InterstitialTech/quadrant-board/README.md

# Quadrant
an open-hardware interface for musical expression
