InterstitialTech/quadrant-board/(commit log)

2022-08-19 import rp2040 footprint to quadrant library
2022-08-19 import rp2040 related footprints
2022-08-19 add midi-out
    [quadrant.sch]
2022-08-19 nfet midi output
    [quadrant.sch]
2022-08-20 changed schematic general header to din-5 180 degree
    [quadrant.sch]
2022-08-20 add trs connectors
    [quadrant.sch]
2022-08-20 Create sj-352x-smt.kicad_mod
    rst jack
2022-08-20 recovering from crash
    [quadrant.sch]
2022-08-20 fixed footprint associations
    [quadrant.sch]
2022-08-20 add srt jacks
    [quadrant.kicad_pcb]
2022-08-20 add midi connector
2022-08-20 add midi footprint
    [quadrant.sch]
2022-08-22 add dac footprint + symbol
2022-08-22 dac captured
    [quadrant.sch]
2022-08-24 add VL53L0x
    [quadrant.kicad_pcb, quadrant.sch]
2022-09-07 replace midi jack with trs, add quad op-amp buffer
    [quadrant.sch]
2022-09-07 add i2c lines
    [quadrant.sch]
2022-09-07 add level shifting for dac
    [quadrant.sch]
2022-09-17 add usb-c
    [quadrant.sch]
2022-09-17 add control pull-down resistors, remove usb micro
    [quadrant.sch]
2022-10-26 add ldo regulator
2022-10-26 add ldo
    [quadrant.sch]
2022-10-26 add junctions where needed
    [quadrant.sch]
2022-10-26 add hierarchical sheets
    [DAC.sch, MIDI.sch, mcu.sch, quadrant.sch, tof-sensors.sch]
2022-10-27 move midi circuit to sheet
    [MIDI.sch]
2022-10-27 move DAC circuit to sheet
    [DAC.sch]
2022-10-27 move midi and dac to sheet, add swd header wiring
    [quadrant.sch]
2022-10-27 move tof sensors to sheet
    [tof-sensors.sch]
2022-10-27 move tof sensors to sheet, add tof enable lines
    [quadrant.sch]
2022-10-27 move mcu to sheet
    [mcu.sch, quadrant.sch]
2022-10-27 remove old mcu
    [quadrant.sch]
2022-10-27 update all passive footprints
    [DAC.sch, MIDI.sch, mcu.sch, quadrant.sch, tof-sensors.sch]
2022-10-27 start new route
    [quadrant.kicad_pcb]
2022-10-27 fixed usb5v-gnd bridge, continue placement
    [DAC.sch, MIDI.sch, mcu.sch, quadrant.kicad_pcb, tof-sensors.sch]
2022-10-28 change crystal footprint
    [mcu.sch]
2022-10-28 re-connect 2.8v to tof-2
    [tof-sensors.sch]
2022-10-28 change crystal footprint to smd
2022-10-28 place DAC components
    [quadrant.kicad_pcb]
2022-10-28 arrange TOF, vregs, bypass caps
    [quadrant.kicad_pcb]
2022-11-02 getting positions ironed out
    [quadrant.kicad_pcb]
2022-11-02 moving tof sensors
    [quadrant.kicad_pcb]
2022-11-02 tof placed
    [quadrant.kicad_pcb]
2022-11-03 change tof resistors to datasheet suggestions
    [mcu.sch, tof-sensors.sch]
2022-11-03 capacitor placement, rearranging audio jacks
    [quadrant.kicad_pcb]
2022-11-03 change mcu capacitor footprint to 0603
    [mcu.sch]
2022-11-03 starting to layout mcu caps
    [quadrant.kicad_pcb]
2022-11-03 everything is on the board!
    [mcu.sch, quadrant.kicad_pcb]
2022-11-04 just saving place
    [mcu.sch, quadrant.kicad_pcb]
2022-11-04 more routing, add 2 new layers
    [DAC.sch, mcu.sch, quadrant.kicad_pcb]
2022-11-06 finished route
    [DAC.sch, quadrant.kicad_pcb]
2022-11-10 changing footprints
    [DAC.sch, mcu.sch, quadrant.csv, quadrant.kicad_pcb, quadrant.sch, quadrant2.csv, tof-sensors.sch]
2022-11-10 add qspi flash
    [mcu.sch]
2022-11-10 fixed routing after adding flash
    [mcu.sch, quadrant.kicad_pcb, quadrant.sch]
2022-11-10 replace crystal with oscillator
    [mcu.sch, quadrant.kicad_pcb]
2022-11-10 0603 most passives
    [DAC.sch, MIDI.sch, mcu.sch, quadrant.kicad_pcb, quadrant.sch, tof-sensors.sch]
2022-11-10 using new audio jack footprint
    [MIDI.sch, quadrant.kicad_pcb, tof-sensors.sch]
2022-11-10 new audio jack
    [quadrant.csv, quadrant.kicad_pcb]
2022-11-11 update 3v3 2v8 vreg
    [quadrant.kicad_pcb, quadrant.sch]
2022-11-11 adding jlc fields
    [DAC.sch, MIDI.sch, mcu.sch, quadrant.sch, tof-sensors.sch]
2022-11-11 more jlc fields
    [DAC.sch, MIDI.sch, mcu.sch, quadrant.sch, tof-sensors.sch]
2022-11-11 replaced 4v8 reg
    [DAC.sch, quadrant.kicad_pcb]
2022-11-11 update jlc fields
    [DAC.sch]
2022-11-11 add new transistor
    [MIDI.sch]
2022-11-11 moving labels
    [MIDI.sch, quadrant.kicad_pcb]
2022-11-11 replace dual mosfet
    [DAC.sch, MIDI.sch]
2022-11-11 usb-c connector update
    [DAC.sch, quadrant.kicad_pcb, quadrant.sch]
2023-04-13 bringing things up to date (not sure what changed, maybe just generated gerbers)
    [quadrant.kicad_pcb]
2023-04-13 connect opamp supply to 4v8 and gnd
    [DAC.sch]
2023-04-13 added power to buffer amp
    [quadrant.kicad_pcb]
2023-04-13 modified trs connectors to reflect actual pinouts, added some art on the back of the pcb
    [DAC.sch, quadrant.kicad_pcb, tof-sensors.sch]
2023-04-13 update bom
    [MIDI.sch, quadrant.sch]
2023-04-15 migrate to kicad 7, add separate 3v3 and 2v8 ldo regulators, remove dual 3v3,2v8 regulator
    [DAC.kicad_sch, DAC.sch, MIDI.kicad_sch, MIDI.sch, mcu.kicad_sch, mcu.sch, quadrant.kicad_pcb, quadrant.kicad_sch]
2023-04-24 not sure why these lib files were modified
    [quadrant.csv, quadrant.kicad_pcb]
2023-04-24 moved component labels
    [DAC.kicad_sch, MIDI.kicad_sch, mcu.kicad_sch, quadrant.kicad_pcb, quadrant.kicad_sch, tof-sensors.kicad_sch]
2023-07-27 removed lcsc properties from passives
    [DAC.kicad_sch, mcu.kicad_sch, tof-sensors.kicad_sch]
2023-07-27 added diodes to xshut line on lidars
    [tof-sensors.kicad_sch]
2023-07-27 change schottky diode, update pcb
    [quadrant.kicad_pcb, tof-sensors.kicad_sch]
2023-07-27 replace reset jumper with switch
    [mcu.kicad_sch]
2023-10-17 remove kicad/ directory
    [DAC.sch, MIDI.sch, mcu.sch, quadrant.csv, quadrant.kicad_pcb, quadrant.sch, quadrant2.csv, tof-sensors.sch]
2023-10-17 rename kicad-7 -> kicad
    [DAC.kicad_sch, DAC.sch, MIDI.kicad_sch, MIDI.sch, mcu.kicad_sch, mcu.sch, quadrant.kicad_pcb, quadrant.kicad_sch]
2023-10-17 remove gerbers/, schematic.pdf, bom.csv
    [bom.csv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]
2023-10-17 remove all legacy and backup files
    [DAC.sch, MIDI.sch, mcu.sch, quadrant.sch, tof-sensors.sch]
2023-10-17 remove *.kicad_sym
2023-10-17 .gitignore: remove kicad/quadrant.xml
2023-12-12 connected MIDIO to GPIO12 and UART0 TX
    [quadrant.kicad_pcb]
2023-12-17 swap buffer to JLCpcb in-stock buffer
    [DAC.kicad_sch]
2023-12-17 shift inputs to connect UART to midi-out
    [mcu.kicad_sch]
2023-12-17 last commit before new placement and re-route
    [quadrant.kicad_pcb]
2023-12-17 add kicad symbol library with AD5317R
2023-12-17 Add AD5317R footprints
2023-12-17 Remove old DAC, remove I2c level shifting, add AD5317R
    [DAC.kicad_sch]
2023-12-17 connect DAC
    [DAC.kicad_sch, mcu.kicad_sch, quadrant.kicad_sch]
2023-12-18 begin reroute! Placed CV-outs
    [quadrant.kicad_pcb]
2023-12-18 top edge placed
    [DAC.kicad_sch, quadrant.kicad_pcb]
2023-12-18 placed TOF2
    [quadrant.kicad_pcb]
2023-12-18 placed TOF3
    [quadrant.kicad_pcb]
2023-12-18 placed TOF0
    [quadrant.kicad_pcb]
2023-12-18 add midi-in
    [MIDI.kicad_sch, mcu.kicad_sch, quadrant.kicad_pcb]
2023-12-19 connect midii and TOF gpio
    [mcu.kicad_sch, quadrant.kicad_sch, tof-sensors.kicad_sch]
2023-12-19 moved midii and midio
    [bom.csv, designators.csv, positions.csv, quadrant.kicad_pcb]
2023-12-19 route dac spi
    [quadrant.kicad_pcb]
2023-12-19 moved a cap
    [quadrant.kicad_pcb]
2023-12-19 breakout extra gpio
    [mcu.kicad_sch]
2023-12-19 wire dip switch
    [mcu.kicad_sch]
2023-12-19 add dip switch, add 4.8/5v dac output voltage, route more gpio
    [DAC.kicad_sch, mcu.kicad_sch, quadrant.kicad_pcb]
2023-12-19 mounting holes?
    [quadrant.kicad_pcb, quadrant.kicad_sch]
2023-12-19 route done?!
    [mcu.kicad_sch, quadrant.kicad_pcb, quadrant.kicad_sch]
2023-12-19 clean up silkscreen
    [quadrant.kicad_pcb]
2023-12-20 new optoisolator
    [DAC.kicad_sch, MIDI.kicad_sch, mcu.kicad_sch, quadrant.kicad_pcb, quadrant.kicad_sch]
2023-12-20 new bootsel pushbutton
    [DAC.kicad_sch, MIDI.kicad_sch, mcu.kicad_sch, quadrant.kicad_pcb, quadrant.kicad_sch]
2023-12-20 all ready for mfg, now with ants!
    [DAC.kicad_sch, MIDI.kicad_sch, mcu.kicad_sch, quadrant.kicad_pcb, quadrant.kicad_sch, tof-sensors.kicad_sch]
2023-12-22 actual mfg
    [quadrant.kicad_pcb]
2025-06-07 update PCB for kicad 9; fix silkscreen (intersital.coop)
    [quadrant.kicad_pcb]
2025-06-07 update schematic: date, revision, kicad 9
    [DAC.kicad_sch, MIDI.kicad_sch, mcu.kicad_sch, quadrant.kicad_sch, tof-sensors.kicad_sch]
